hoangbui226/stm32-PID-ball-controller/model/esp32-cam/thing6119274/images/esp32-cam.jpg

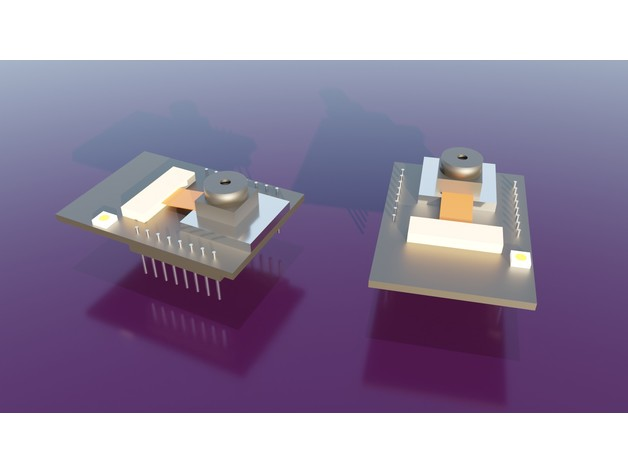
model/esp32-cam/thing6119274/images/esp32-cam.jpg
