hoangbui226/stm32-PID-ball-controller/model/esp32-cam/ESP32-CAM.stl

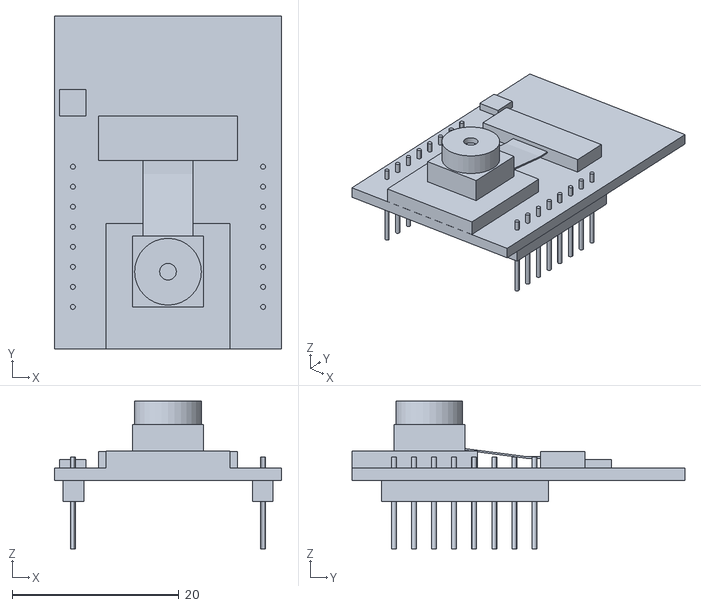
[picture p3: CAD file, 2026-11-10]
model/esp32-cam/ESP32-CAM.stl
27.2 x 39.9 x 17.7
