hoangbui226/stm32-PID-ball-controller/model/print/arm_hook_x3.3mf

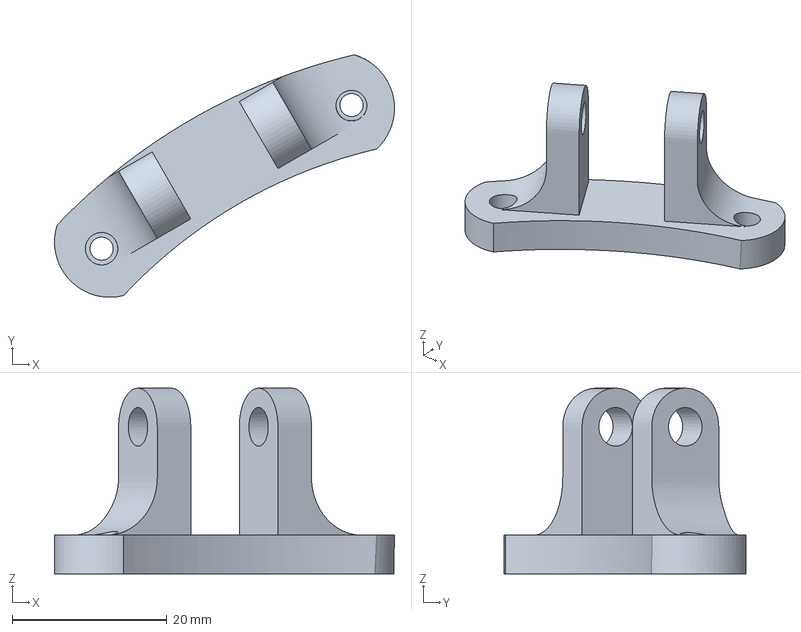
[picture p4: CAD file, 2026-11-10]
model/print/arm_hook_x3.3mf
43.9 x 31.3 x 24.0 mm
