hoangbui226/stm32-PID-ball-controller/model/stm32-l152/NUCLEO-L152RE.step

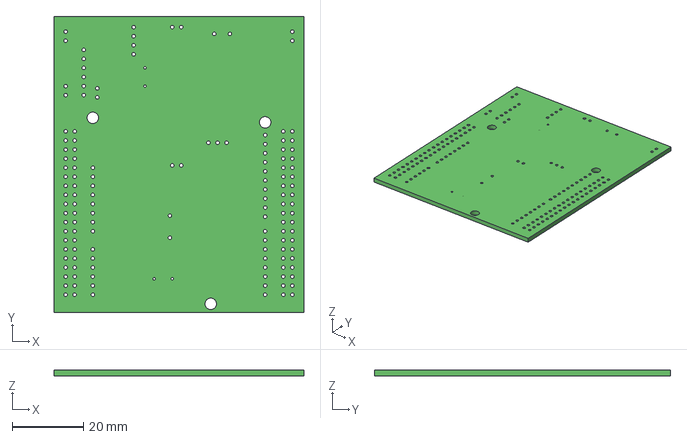
[picture p5: CAD file, 2026-11-10]
model/stm32-l152/NUCLEO-L152RE.step
70.0 x 83.0 x 1.59 mm
