hoangbui226/stm32-PID-ball-controller/model/print/cam_holder_1_x1.3mf

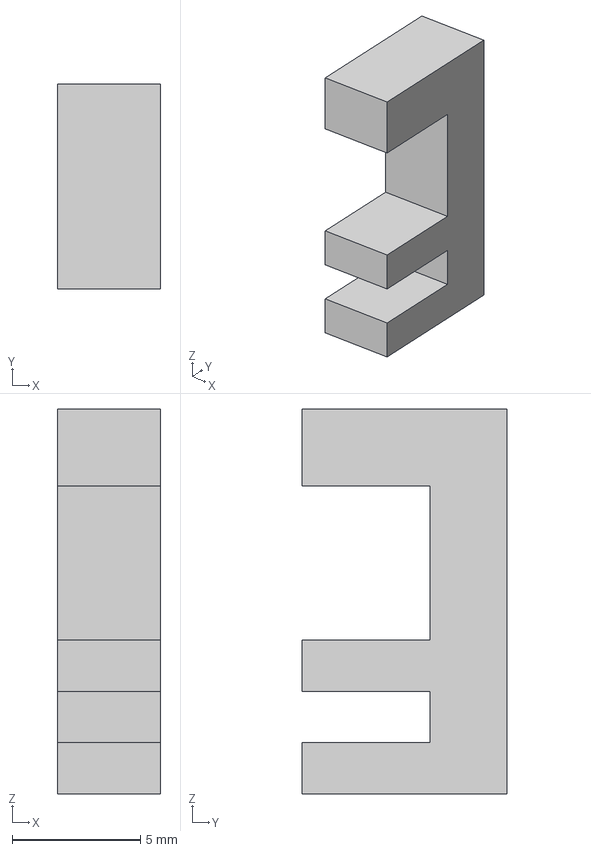
[picture p6: CAD file, 2026-11-10]
model/print/cam_holder_1_x1.3mf
4.00 x 8.00 x 15.0 mm
