hoangbui226/stm32-PID-ball-controller/model/print/wall_v5_x6.3mf

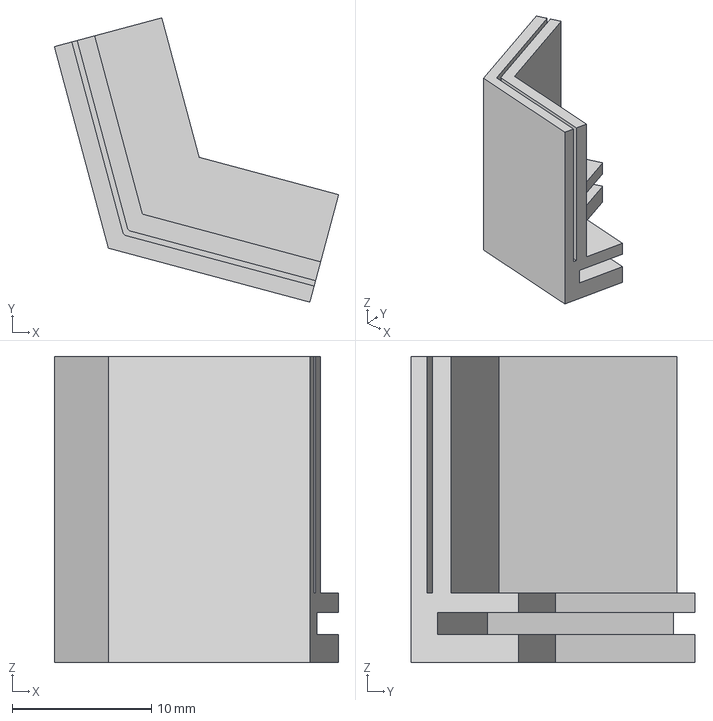
[picture p7: CAD file, 2026-11-10]
model/print/wall_v5_x6.3mf
20.4 x 20.4 x 22.0 mm
