hoangbui226/stm32-PID-ball-controller/model/print/arm1_x3.3mf

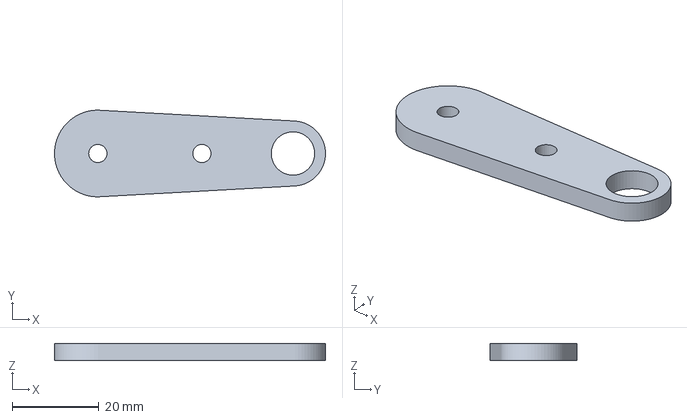
[picture p9: CAD file, 2026-11-10]
model/print/arm1_x3.3mf
62.5 x 20.0 x 4.00 mm
