hoangbui226/stm32-PID-ball-controller/model/print/upper_leg_middle_plane_x6.3mf

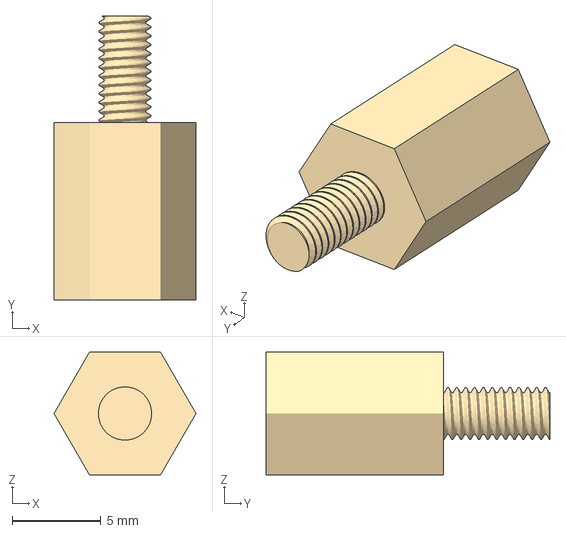
[picture p10: CAD file, 2026-11-10]
model/print/upper_leg_middle_plane_x6.3mf
8.00 x 16.0 x 6.93 mm
