hoangbui226/stm32-PID-ball-controller/model/print/hook_v3_x3.3mf

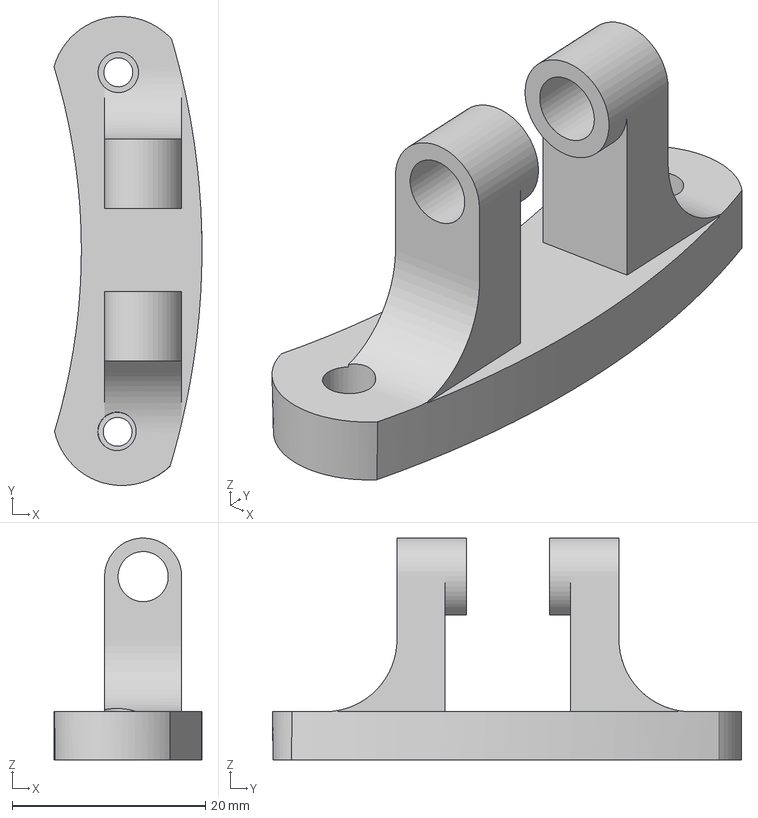
[picture p11: CAD file, 2026-11-10]
model/print/hook_v3_x3.3mf
15.3 x 48.6 x 23.0 mm
