hoangbui226/stm32-PID-ball-controller/model/print/Barrel_Jack_Cover_x1.3mf

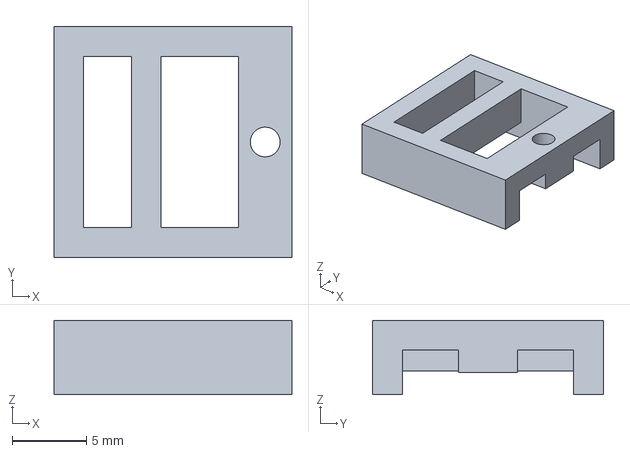
[picture p12: CAD file, 2026-11-10]
model/print/Barrel_Jack_Cover_x1.3mf
16.0 x 15.5 x 5.00 mm
