hoangbui226/stm32-PID-ball-controller/model/print/arm2_x3.3mf

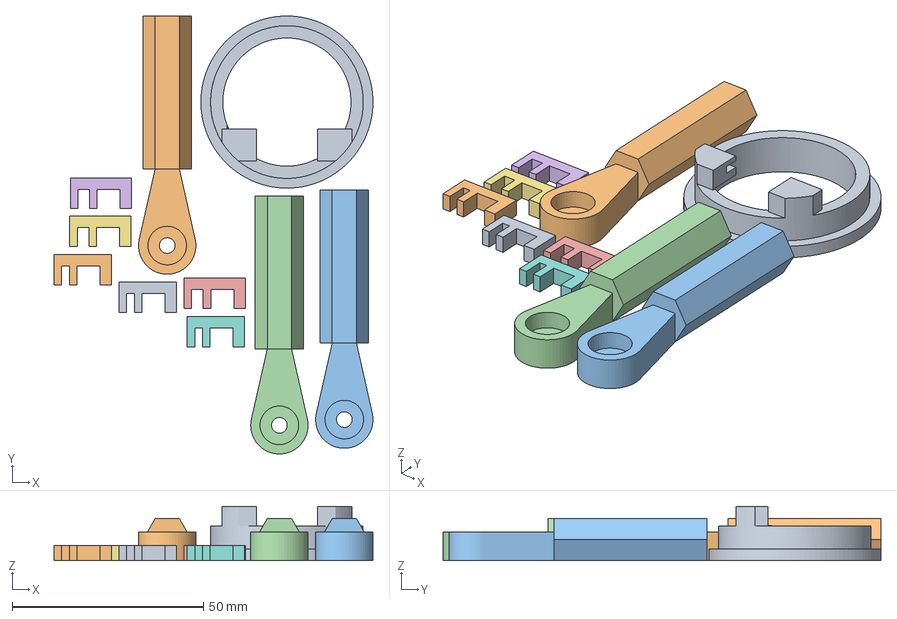
[picture p13: CAD file, 2026-11-10]
model/print/arm2_x3.3mf
83.4 x 114.5 x 14.2 mm
camera holder x 3
camera holder (1) x 3
