hoangbui226/stm32-PID-ball-controller/model/print/top_plane_x1.3mf

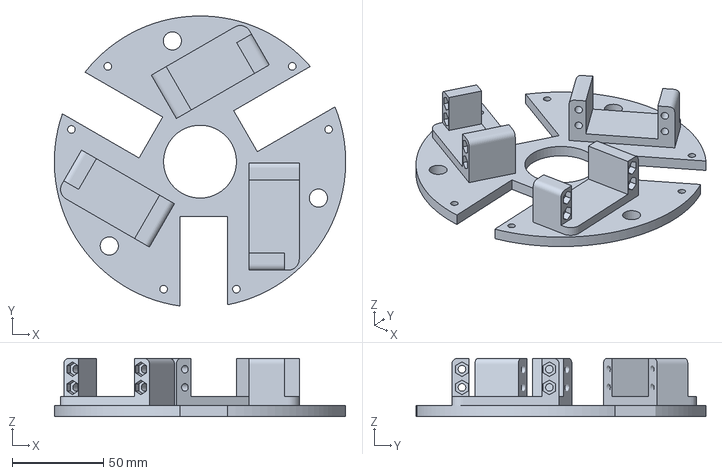
[picture p14: CAD file, 2026-11-10]
model/print/top_plane_x1.3mf
160.0 x 159.2 x 31.9 mm
