hoangbui226/stm32-PID-ball-controller/model/print/upper_leg_bottom_plane_x3.3mf

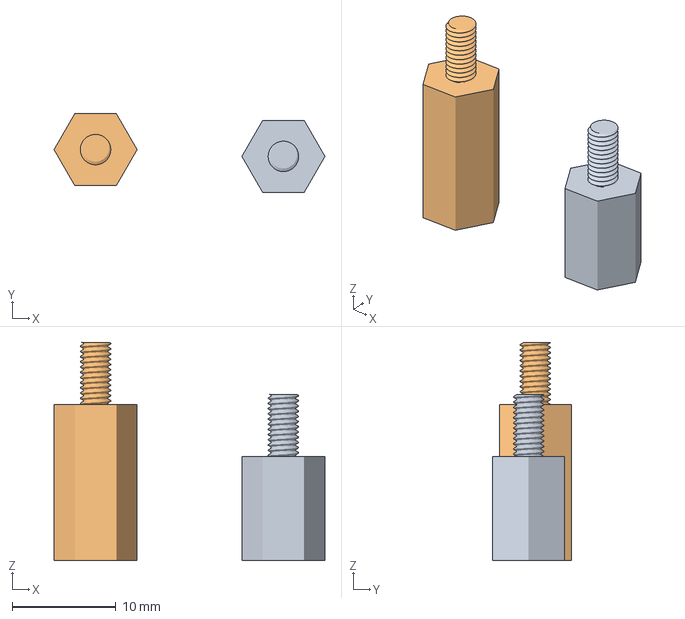
[picture p15: CAD file, 2026-11-10]
model/print/upper_leg_bottom_plane_x3.3mf
26.1 x 7.58 x 21.0 mm
