hoangbui226/stm32-PID-ball-controller/model/print/middle_plane_x1.3mf

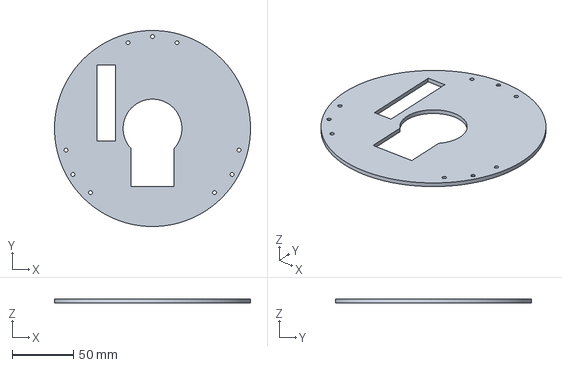
[picture p16: CAD file, 2026-11-10]
model/print/middle_plane_x1.3mf
160.0 x 160.0 x 3.00 mm
