hoangbui226/stm32-PID-ball-controller/model/print/lower_leg_bottom_plane_x3.3mf

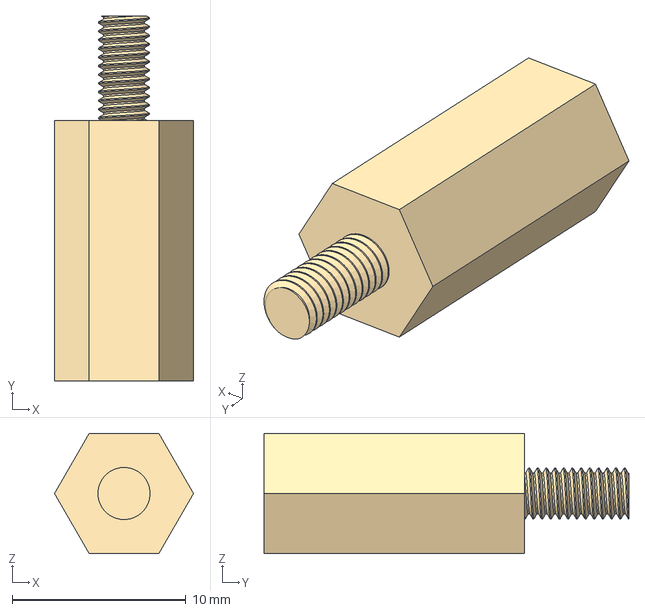
[picture p18: CAD file, 2026-11-10]
model/print/lower_leg_bottom_plane_x3.3mf
8.00 x 21.0 x 6.93 mm
