hoangbui226/stm32-PID-ball-controller/model/print/wall_x6.3mf

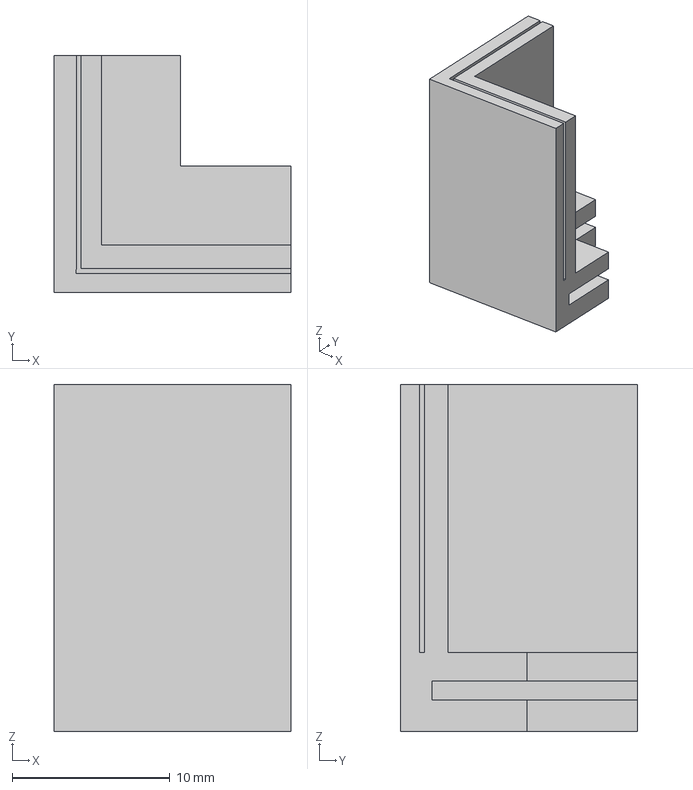
[picture p19: CAD file, 2026-11-10]
model/print/wall_x6.3mf
15.0 x 15.0 x 22.0 mm
