hoangbui226/stm32-PID-ball-controller/model/print/camera_mount_x1.3mf

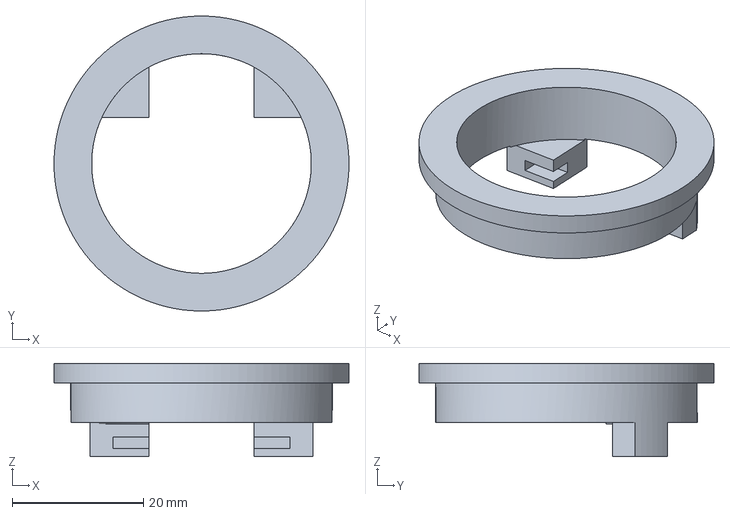
[picture p20: CAD file, 2026-11-10]
model/print/camera_mount_x1.3mf
45.0 x 45.0 x 14.2 mm
