hoangbui226/stm32-PID-ball-controller/model/print/bottom_plane_x1.3mf

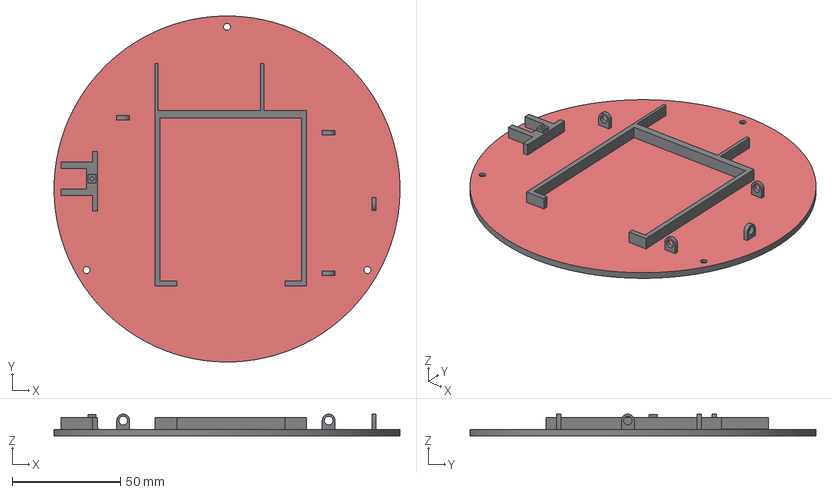
[picture p21: CAD file, 2026-11-10]
model/print/bottom_plane_x1.3mf
160.0 x 160.0 x 10.1 mm
