hoangbui226/stm32-PID-ball-controller/(list of files, cad)

Other CAD files:
model/print/print1.3mf
model/print/hook_v2_x3.3mf
model/print/wall_v2_x6.3mf
model/print/wall_v3_x6.3mf
model/print/wall_v4_x6.3mf
model/stm32-l152/NUCLEO-L152RE.stl
