hoangbui226/stm32-PID-ball-controller/PCB/PCB/PCB.kicad_pcb

## KiCad design hardware/pcb/pcb.kicad_sch

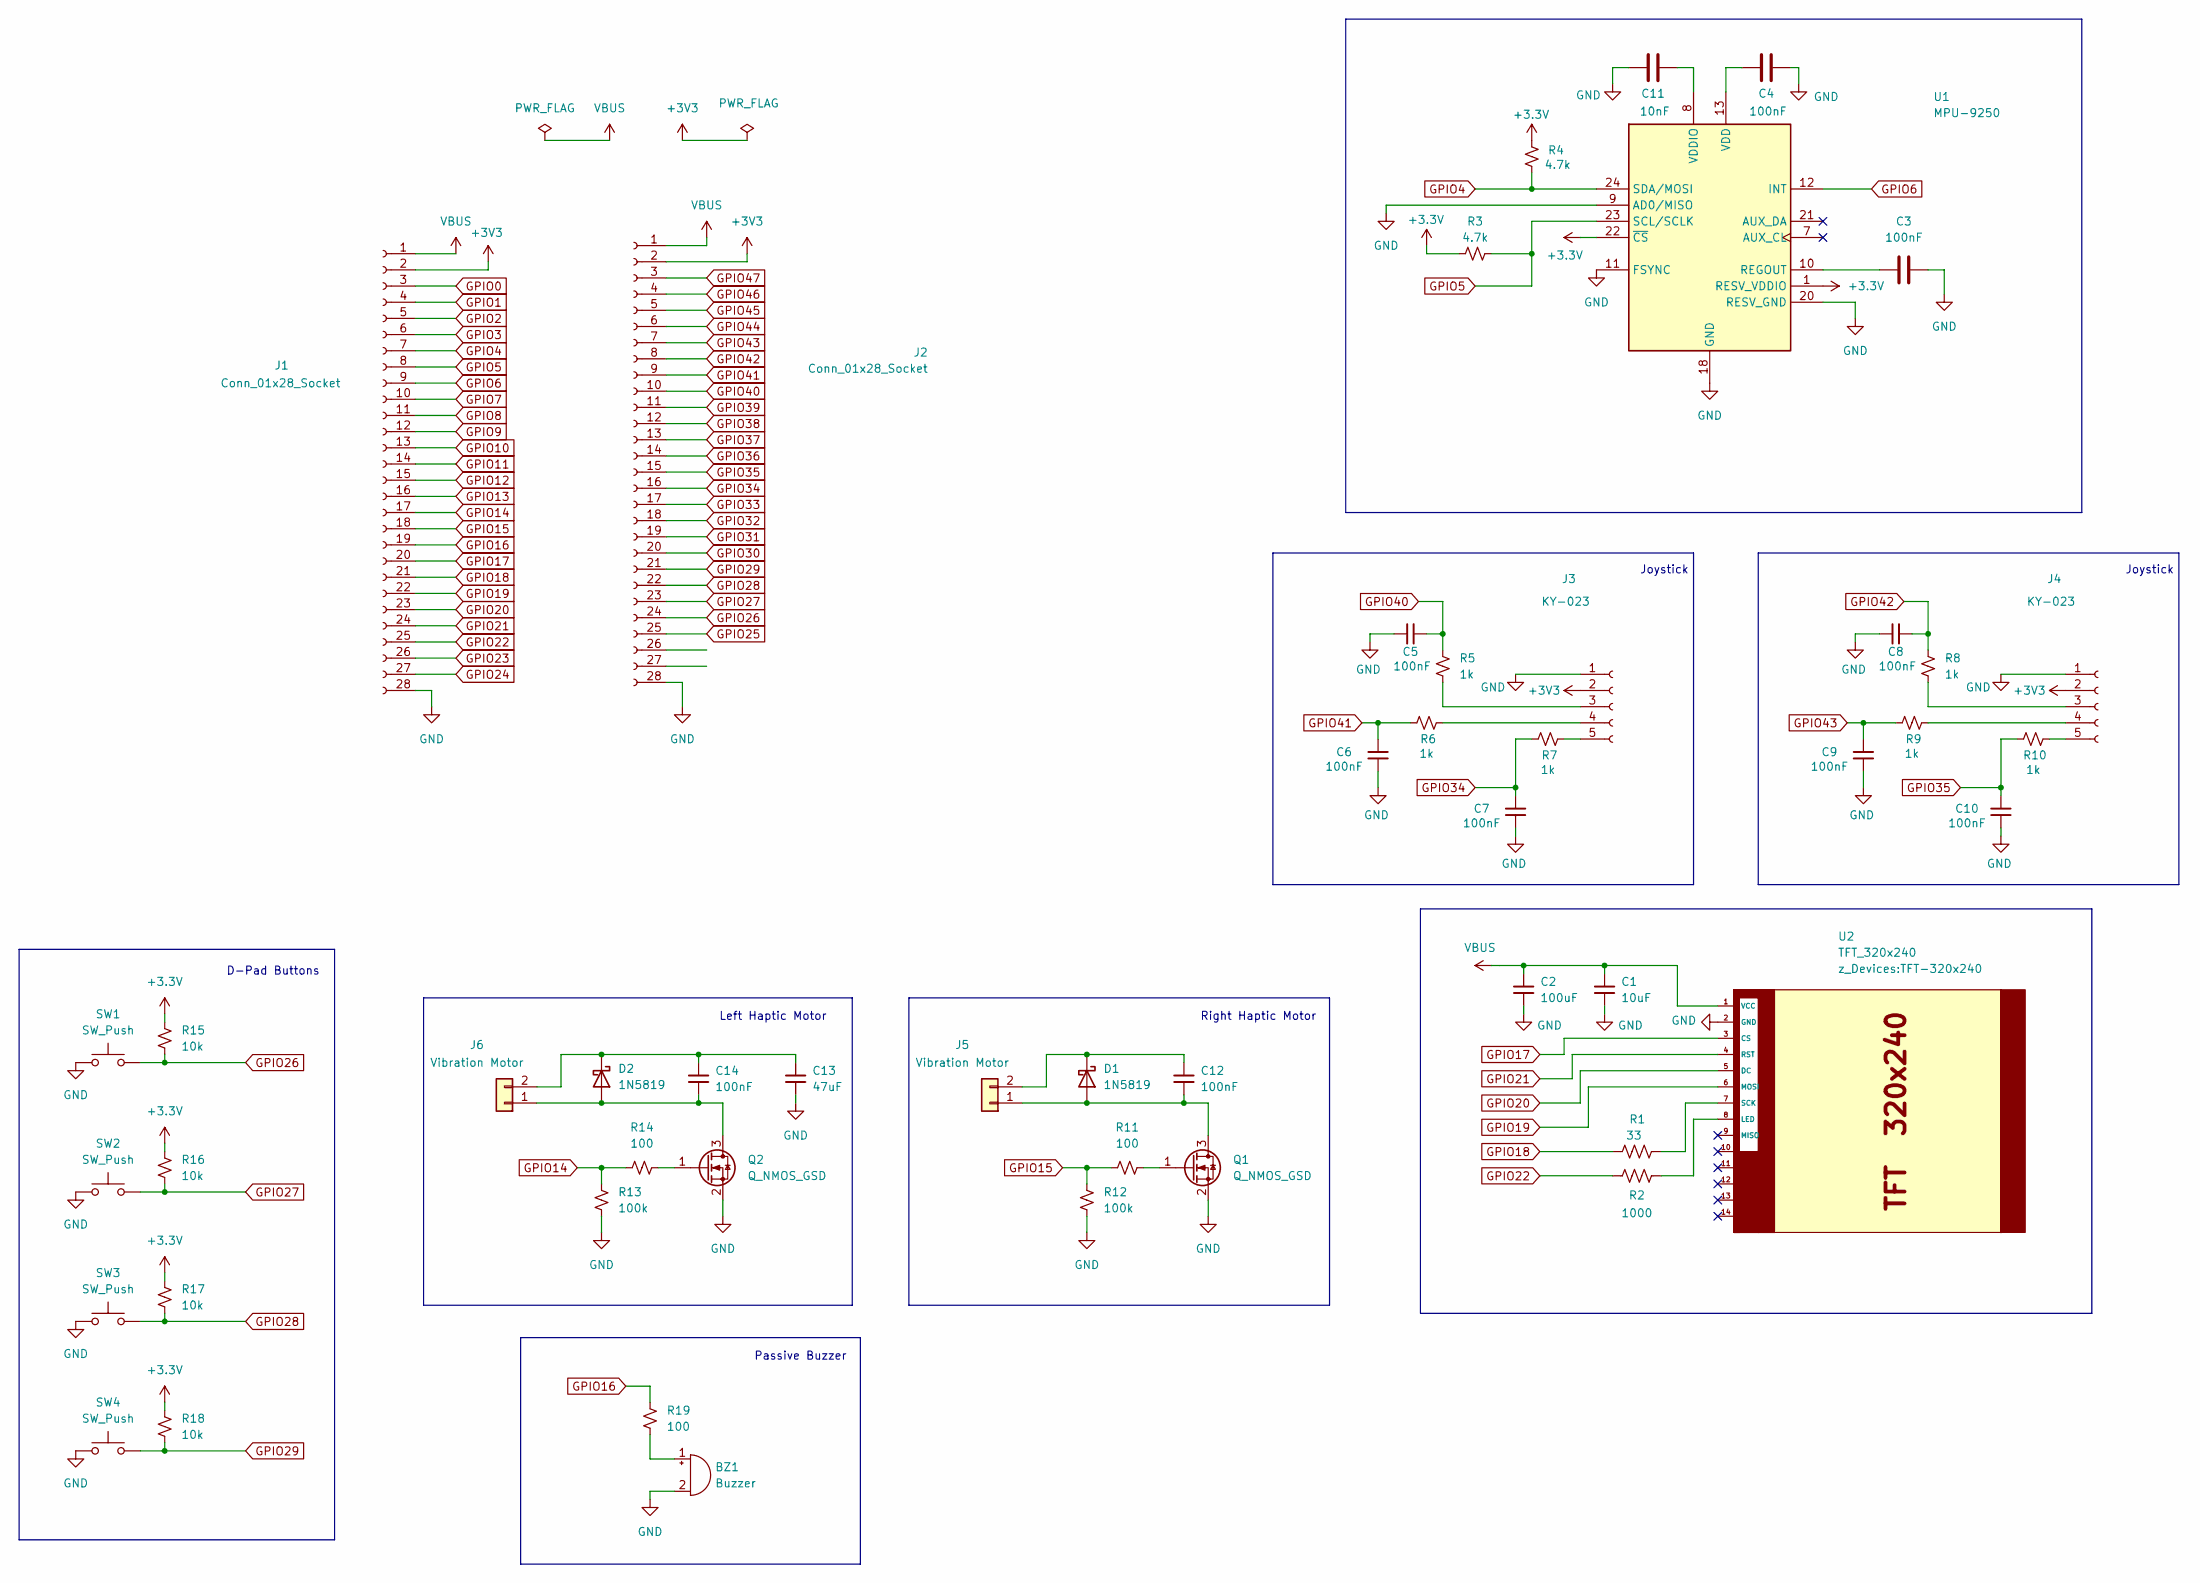
[picture p22: schematic pcb.kicad_sch]

Parts:
BZ1: Buzzer
C1: 10uF
C2: 100uF
C3, C4, C5, C6, C7, C8, C9, C10, C12, C14: 100nF
C11: 10nF
C13: 47uF
D1, D2: 1N5819; D_DO-41_SOD81_P10.16mm_Horizontal
J1, J2: Conn_01x28_Socket
J3, J4: KY-023
J5, J6: Vibration Motor
Q1, Q2: Q_NMOS_GSD
R1: 33
R2: 1000
R3, R4: 4.7k
R5, R6, R7, R8, R9, R10: 1k
R11, R14, R19: 100
R12, R13: 100k
R15, R16, R17, R18: 10k
SW1, SW2, SW3, SW4: SW_Push
U1: MPU-9250; InvenSense_QFN-24_3x3mm_P0.4mm
U2: TFT_320x240; TFT-320x240

Connections:
+3.3V: R3.2, R4.2, R15.1, R16.1, R17.1, R18.1, U1.1 (RESV_VDDIO), U1.22 (~CS)
+3V3: J1.2, J2.2, J3.2, J4.2
GND: BZ1.2 (-), C1.2, C2.2, C3.1, C4.1, C5.2, C6.1, C7.1, C8.2, C9.1, C10.1, C11.2, C13.2, J1.28, J2.28, J3.1, J4.1, Q1.2 (S), Q2.2 (S), R12.2, R13.2, SW1.1, SW2.1, SW3.1, SW4.1, U1.9 (AD0/MISO), U1.11 (FSYNC), U1.18 (GND), U1.20 (RESV_GND), U2.2 (GND)
GPIO0: J1.3
GPIO1: J1.4
GPIO2: J1.5
GPIO3: J1.6
GPIO4: J1.7, R4.1, U1.24 (SDA/MOSI)
GPIO5: J1.8, R3.1, U1.23 (SCL/SCLK)
GPIO6: J1.9, U1.12 (INT)
GPIO7: J1.10
GPIO8: J1.11
GPIO9: J1.12
GPIO10: J1.13
GPIO11: J1.14
GPIO12: J1.15
GPIO13: J1.16
GPIO14: J1.17, R13.1, R14.2
GPIO15: J1.18, R11.2, R12.1
GPIO16: J1.19, R19.2
GPIO17: J1.20, U2.3 (CS)
GPIO18: J1.21, R1.2
GPIO19: J1.22, U2.6 (MOSI)
GPIO20: J1.23, U2.5 (DC)
GPIO21: J1.24, U2.4 (RST)
GPIO22: J1.25, R2.2
GPIO23: J1.26
GPIO24: J1.27
GPIO25: J2.25
GPIO26: J2.24, R15.2, SW1.2
GPIO27: J2.23, R16.2, SW2.2
GPIO28: J2.22, R17.2, SW3.2
GPIO29: J2.21, R18.2, SW4.2
GPIO30: J2.20
GPIO31: J2.19
GPIO32: J2.18
GPIO33: J2.17
GPIO34: C7.2, J2.16, R7.1
GPIO35: C10.2, J2.15, R10.1
GPIO36: J2.14
GPIO37: J2.13
GPIO38: J2.12
GPIO39: J2.11
GPIO40: C5.1, J2.10, R5.2
GPIO41: C6.2, J2.9, R6.1
GPIO42: C8.1, J2.8, R8.2
GPIO43: C9.2, J2.7, R9.1
GPIO44: J2.6
GPIO45: J2.5
GPIO46: J2.4
GPIO47: J2.3
unnamed: BZ1.1 (+), R19.1
unnamed: C1.1, C2.1, U2.1 (VCC)
unnamed: C3.2, U1.10 (REGOUT)
unnamed: C4.2, U1.13 (VDD)
unnamed: C11.1, U1.8 (VDDIO)
unnamed: C12.1, D1.1 (K), J5.2
unnamed: C12.2, D1.2 (A), J5.1, Q1.3 (D)
unnamed: C13.1, C14.1, D2.1 (K), J6.2
unnamed: C14.2, D2.2 (A), J6.1, Q2.3 (D)
unnamed: J3.3, R5.1
unnamed: J3.4, R6.2
unnamed: J3.5, R7.2
unnamed: J4.3, R8.1
unnamed: J4.4, R9.2
unnamed: J4.5, R10.2
unnamed: Q1.1 (G), R11.1
unnamed: Q2.1 (G), R14.1
unnamed: R1.1, U2.7 (SCK)
unnamed: R2.1, U2.8 (LED)
VBUS: J1.1, J2.1

Notes on the sheet:
Joystick
Right Haptic Motor
Left Haptic Motor
D-Pad Buttons
Passive Buzzer
