hoangbui226/stm32-PID-ball-controller/STM32_Ball_Balancer/Core/Src/main.c

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
/* Includes ------------------------------------------------------------------*/
#include "main.h"

/* USER CODE BEGIN Includes */
#include "ik.h"
#include "pid.h"
/* USER CODE END Includes */

TIM_HandleTypeDef htim2;
TIM_HandleTypeDef htim3;

/* USER CODE BEGIN PV */
static const int kMinCount = 1000;
static const int deadband = 10;
static int ball_x = 160;
static int ball_y = 120;
static int ball_count = 0;
static int err_x = 0;
static int err_y = 0;
/* USER CODE END PV */

void SystemClock_Config(void);
static void MX_GPIO_Init(void);
static void MX_TIM2_Init(void);
static void MX_TIM3_Init(void);
/* USER CODE BEGIN PFP */
static void servos_set_deg(uint8_t a, uint8_t b, uint8_t c);
static void servos_startup(void);
static void uart_cam_init(void);
static int filter_x_y(int x, int y, int count);
static int uart_poll(void);
static uint8_t float_to_deg(float degrees);
/* USER CODE END PFP */

/* USER CODE BEGIN 0 */

static uint16_t deg_to_us(uint8_t degrees)
{
  if (degrees > 180) {
    degrees = 180;
  }
  return (uint16_t)(500 + ((uint32_t)degrees * 2000) / 180);
}

static void servos_set_deg(uint8_t a, uint8_t b, uint8_t c)
{
  __HAL_TIM_SET_COMPARE(&htim2, TIM_CHANNEL_1, deg_to_us(a) + 20); /* PA5, D13 */
  __HAL_TIM_SET_COMPARE(&htim3, TIM_CHANNEL_1, deg_to_us(b)); /* PA6, D12 */
  __HAL_TIM_SET_COMPARE(&htim3, TIM_CHANNEL_2, deg_to_us(c)); /* PA7, D11 */
}

static void servos_startup(void) {
	servos_set_deg(95, 95, 95);
	HAL_Delay(200);
	servos_set_deg(10, 10, 10);
	HAL_Delay(200);
	servos_set_deg(62, 62, 62);
}

/* ESP32 GPIO1 TX -> PA10 D2 USART1 RX. */
static void uart_cam_init(void)
{
  GPIO_InitTypeDef gpio = {0};

  __HAL_RCC_GPIOA_CLK_ENABLE();
  __HAL_RCC_USART1_CLK_ENABLE();
  __HAL_RCC_USART2_CLK_ENABLE();

  gpio.Mode = GPIO_MODE_AF_PP;
  gpio.Pull = GPIO_PULLUP;
  gpio.Speed = GPIO_SPEED_FREQ_HIGH;
  gpio.Alternate = GPIO_AF7_USART1;
  gpio.Pin = GPIO_PIN_10;
  HAL_GPIO_Init(GPIOA, &gpio);

  gpio.Alternate = GPIO_AF7_USART2;
  gpio.Pin = GPIO_PIN_2;
  HAL_GPIO_Init(GPIOA, &gpio);

  /* 16 MHz clock, 115200 baud, oversampling 16. */
  USART1->CR1 = 0;
  USART1->BRR = 139;
  USART1->CR1 = USART_CR1_UE | USART_CR1_RE;

  USART2->CR1 = 0;
  USART2->BRR = 139;
  USART2->CR1 = USART_CR1_UE | USART_CR1_TE;
}

// send character to UART
static void uart_tx(char c)
{
  while ((USART2->SR & USART_SR_TXE) == 0) {
  }
  USART2->DR = (uint8_t)c;
}

// write integer to UART
static void uart_write_int(int value)
{
  char digits[8];
  int count = 0;

  if (value < 0) {
    uart_tx('-');
    value = -value;
  }
  if (value == 0) {
    uart_tx('0');
    return;
  }
  while (value > 0 && count < 8) {
    digits[count++] = (char)('0' + (value % 10));
    value /= 10;
  }
  while (count > 0) {
    uart_tx(digits[--count]);
  }
}

// format the sample from UART
static int read_sample(const char *text, int *x, int *y, int *count)
{
  int value = 0;
  int field = 0;

  while (*text != '\0') {
    if (*text == ' ') {
      if (field == 0) {
        *x = value;
      } else if (field == 1) {
        *y = value;
      }
      if (field < 2) {
        field++;
        value = 0;
      }
    } else if (*text >= '0' && *text <= '9') {
      value = value * 10 + (*text - '0');
    }
    text++;
  }
  if (field != 2) {
    return 0;
  }
  *count = value;
  return 1;
}

static uint8_t float_to_deg(float degrees)
{
  int rounded;

  if (degrees < 0.0f) {
    return 0;
  }
  rounded = (int)(degrees + 0.5f);
  if (rounded > 180) {
    return 180;
  }
  return (uint8_t)rounded;
}

/* Keep a sample only when count > 1000. Otherwise leave ball_x / ball_y alone. */
static int filter_x_y(int x, int y, int count)
{
  ball_count = count;
  if (count <= kMinCount) {
    return 0;
  }

  ball_x += (x - ball_x) * 10 / 10;
  ball_y += (y - ball_y) * 10 / 10;
  err_x = ball_x - 160;
  err_y = ball_y - 120;
  if (err_x >= -deadband && err_x <= deadband) {
    err_x = 0;
  }
  if (err_y >= -deadband && err_y <= deadband) {
    err_y = 0;
  }
  return 1;
}

static int uart_poll(void)
{
  static char line[24];
  static int length = 0;
  int got = 0;

  while ((USART1->SR & USART_SR_RXNE) != 0) {
    char c = (char)(USART1->DR & 0xFF);
    if (c == '\n' || c == '\r') {
      if (length > 0) {
        int x = 0;
        int y = 0;
        int count = 0;
        line[length] = '\0';
        if (read_sample(line, &x, &y, &count)) {
          if (filter_x_y(x, y, count)) {
            got = 1;
          }
          uart_write_int(ball_x);
          uart_tx(' ');
          uart_write_int(ball_y);
          uart_tx(' ');
          uart_write_int(ball_count);
          uart_tx('\r');
          uart_tx('\n');
        }
        length = 0;
      }
    } else if (length < (int)sizeof(line) - 1) {
      line[length++] = c;
    }
  }
  return got;
}
/* USER CODE END 0 */

/**
  * @brief  The application entry point.
  * @retval int
  */
int main(void)
{

  /* MCU Configuration--------------------------------------------------------*/

  /* Reset of all peripherals, Initializes the Flash interface and the Systick. */
  HAL_Init();

  /* Configure the system clock */
  SystemClock_Config();

  /* Initialize all configured peripherals */
  MX_GPIO_Init();
  MX_TIM2_Init();
  MX_TIM3_Init();
  /* USER CODE BEGIN 2 */
  HAL_TIM_PWM_Start(&htim2, TIM_CHANNEL_1); /* PA5, D13 */
  HAL_TIM_PWM_Start(&htim3, TIM_CHANNEL_1); /* PA6, D12 */
  HAL_TIM_PWM_Start(&htim3, TIM_CHANNEL_2); /* PA7, D11 */

  servos_startup();
  uart_cam_init();
   /* USER CODE END 2 */

   
  /* Infinite loop */
  /* USER CODE BEGIN WHILE */
  while (1)
  {
    /* USER CODE END WHILE */

    /* USER CODE BEGIN 3 */
    if (uart_poll()) {
      float theta_deg;
      float phi_deg;
      float deg1;
      float deg2;
      float deg3;

      pid((float)err_x, (float)err_y, &theta_deg, &phi_deg);
      phi_deg += 180.0f;
      if (phi_deg >= 360.0f) {
        phi_deg -= 360.0f;
      }
      if (ik_solve(theta_deg, phi_deg, &deg1, &deg2, &deg3)) {
        servos_set_deg(float_to_deg(deg1), float_to_deg(deg2), float_to_deg(deg3));
      }
    }
  }
  /* USER CODE END 3 */
}

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
