hoangbui226/stm32-PID-ball-controller/(commit log)

2026-10-28 Hold the plate at the working angle and add the controller board.
    [PCB.kicad_pcb, PCB.kicad_sch]
2026-10-30 Add the plate inverse kinematics and print the level pose with each camera sample.
2026-11-10 Add PID plate control and report only the ball position.
    Move the printable models under model and add a MATLAB check of the same loop.
    [Barrel_Jack_Cover_x1.3mf, ESP32-CAM.stl, NUCLEO-L152RE.step, NUCLEO-L152RE.stl, arm1_x3.3mf, arm2_x3.3mf, arm_hook_x3.3mf, bottom_plane_x1.3mf]
2026-11-12 Track the largest orange blob and soften the plate tilt.
    Send the ball position when detection finishes, and trim the servo startup pose.
