hoangbui226/stm32-PID-ball-controller/(notices)

Notices in the files:
STM32_Ball_Balancer/Core/Src/main.c:
Copyright (c) 2026 STMicroelectronics.
All rights reserved.
This software is licensed under terms that can be found in the LICENSE file
